sstadlberger/botvac-wifi/(threads)

Thread 1 (2016-10-21):

Can this be used on the older Neato's?

Swiftnesses, 2016-10-21:
Hi,

Excellent mod, got to love the ESP's :-)

Do you know if this mod could be applied to the older Neato's (I actually own a Vorwerk VR100).

Thanks in advance,

Mark

sstadlberger, 2016-10-23:
I only have the BotVac 85, so I can't check it, but in principle yes. But it depends on if your board has an exposed serial port. From what I've read on the Internet some versions of the VR100 have a serial connection labeled P3 where you could connect an ESP module.

See for example here: http://www.roboter-forum.com/showthread.php?3661

Depending on the serial connection you may have to change the connection speed (see here: https://github.com/sstadlberger/botvac-wifi/blob/52fbc242da4201e009124b31141e1de037e9baa5/botvac-wifi.ino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)

The ESP module in this code just acts as an transparent serial to websocket bridge and can be used in different applications (not just robot vacuums).

jonvic1891, 2017-01-19:
Hi, do you know if plugging  a NRF24LU1 usb from module directly into the USB port would work, it has a slightly higher operating voltage of 3.7 to 5.5 volts but would mean no soldering etc. Also would it take the software. Reason why I'm going RF is that I think I could controll it with my Broadlink RM pro as that is hooked into my smartthings hub so I don't need the ST shield.

sstadlberger, 2017-01-21:
I'm not really familiar with the NRF24LU1 module but from I read it should not work for the following reasons:

- Both the BotVac and the NRF24LU1 module need to be plugged into a host device (i.e. a computer like device that also supplies power). To use a NRF24LU1 module directly on the BotVac's USB port it would need to act as a USB host controller for the BotVac and also contain the appropriate drivers.
- The software should also not work, because all it is doing is establishing a websocket connection via WiFi. That is completely than 2.4GHz RF.
- Only connect 3.3V devices to 3.3V devices. If you use a different voltage on the BotVac board than it was designed for, then you have a very high probability to instantly destroy your BotVac mainboard.

Sorry that I could not be more helpful, but I designed this solution for just a single use case. If you want to expand it to other use cases you are very welcome to contribute.

Closed 2017-10-13.

Thread 3 (2017-01-28):

Please Can you implement mqtt client?

uronito, 2017-01-28:
This project is wonderful!!!!

Please Can you implement mqtt client?

Thanks in advance.

Regards

sstadlberger, 2017-01-29:
I'm sorry but I don't know anything about about MQTT and sadly my time is somewhat limited. But you are very welcome to contribute.

uronito, 2017-01-29:
One question please.

If i use esp8266-01 , must connect ch_pd,rest pins to vcc?

Thanks!!!

sstadlberger, 2017-01-29:
CH_PD and REST should be pulled to 3.3V, ideally via a 1k resistor.

Please see the ESP8266 Community wiki for more information on getting started:
http://www.esp8266.com/wiki/doku.php?id=getting-started-with-the-esp8266

There is also a forum where you can ask general ES8266 questions:
http://www.esp8266.com/

Closed 2017-01-29.

Thread 4 (2017-05-18):

What connector did you use?

craftyguy, 2017-05-18:
>  I used Dupont connectors.

Do you have a link to it on digikey or elsewhere?

sstadlberger, 2017-05-19:
For example: https://www.aliexpress.com/item/o/32801013353.html

I just used them to be able to disconnect the cable. The cable itself is soldered to the board because I couldn't find a proper connector. Please share if you find one.

craftyguy, 2017-05-20:
Oh, ok, I see. I thought you found a proper connector to connect directly to the board, I didn't know what a 'dupont connector' was until now. I have ultimately done the same thing you did, soldered wires directly to board, with a similar style connector at the other end. Sorry for the frivolous issue 'ticket', it was the only way I could ask you this question!

Closed 2017-05-20.

Thread 7 (2018-04-09):

Connector on Vorwerk VR100

dewi-ny-je, 2018-04-09:
This is not an issue, more a support request.

Are you aware of similar connectors on the Vorwerk VR100? it's based on the Neato, with minor mechanical and battery changes. The display even shows "Neato".

When I opened it I couldn't find anything clearly labeled as "TX, RX".

sstadlbergerxamine, 2018-04-09:
Sorry, I'm aware that the Vorwerk vacuums are based on Neato (they even bought Neato last year), but I've never been able to examine one.

If you have an oscilloscope with a serial decoder you might be able to probe the board and find the proper connections. I don't have any further ideas.

sstadlberger, 2018-04-09:
Sorry, I'm aware that the Vorwerk vacuums are based on Neato (they even bought Neato last year), but I've never been able to examine one.

If you have an oscilloscope with a serial decoder you might be able to probe the board and find the proper connections. I don't have any further ideas.

berti92, 2020-01-19:
It works on VR100 I own myself, too. But keep in mind that there are a few revisions which don't support Serial.

Closed 2020-05-02.
