sstadlberger/botvac-wifi/(commit log)

2017-06-16 Over the air update (ArduinoOTA) support added.
2020-05-02 - updated it so it works with current libraries - removed mDNS support as the old version is broken (probably temporary) - added CTRL-Z to "connected to Neato" so that all outgoing repsonses are term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
    [botvac-wifi.ino]
